sayali7242/Gesture-Controlled-Home-Automation/arduino_secrets.h

// Fill in  your WiFi networks SSID and password
#define SECRET_SSID ""
#define SECRET_PASS ""

// Fill in the hostname of your AWS IoT broker
#define SECRET_BROKER ""

// Fill in the boards public certificate
const char SECRET_CERTIFICATE[] = R"(
-----BEGIN CERTIFICATE-----
certificate here
-----END CERTIFICATE-----

)";
